conquat/DSP-hw/Modelli 3d/nc3mah.stp

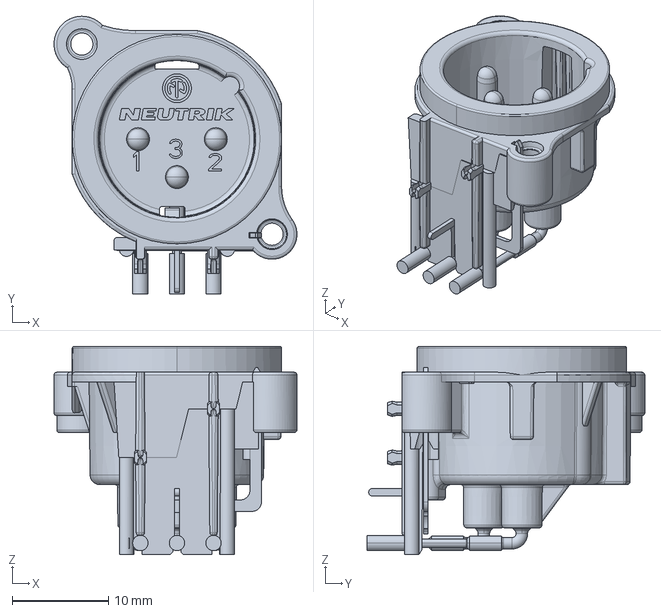
[picture p1: CAD file, 2026-07-23]
Modelli 3d/nc3mah.stp
25.3 x 28.9 x 21.7 mm
