conquat/DSP-hw/Modelli 3d/3D Model NCJ6FA-H.stp

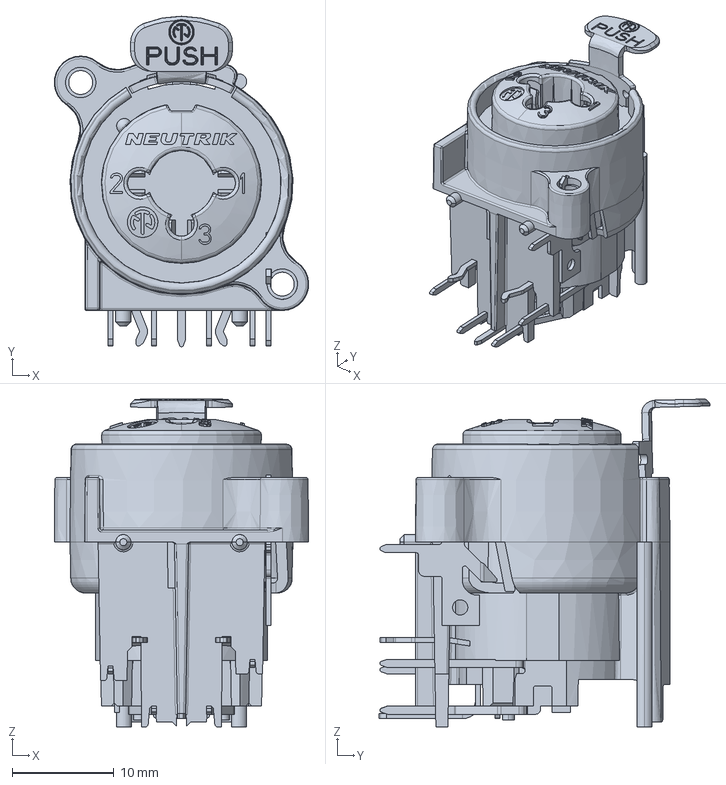
[picture p2: CAD file, 2026-07-23]
Modelli 3d/3D Model NCJ6FA-H.stp
25.0 x 32.5 x 32.2 mm
