conquat/DSP-hw/Modelli 3d/RK09Y11L0001.stp

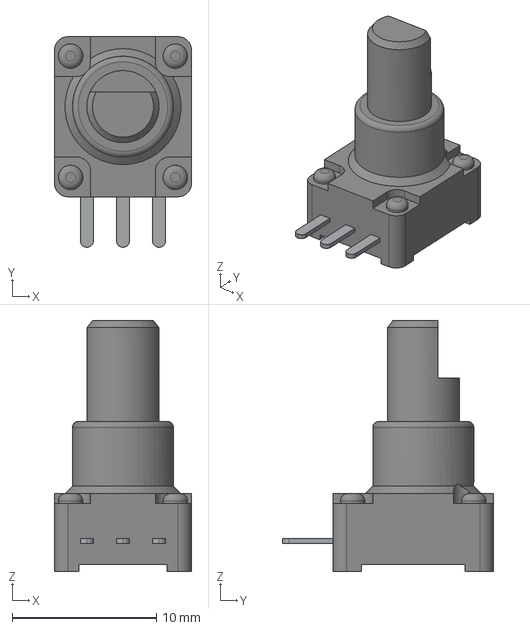
[picture p3: CAD file, 2026-07-23]
Modelli 3d/RK09Y11L0001.stp
9.50 x 14.6 x 17.4 mm
