conquat/DSP-hw/DSP-hw.kicad_pcb

## KiCad design DSP-hw.kicad_pcb (2026-08-07)

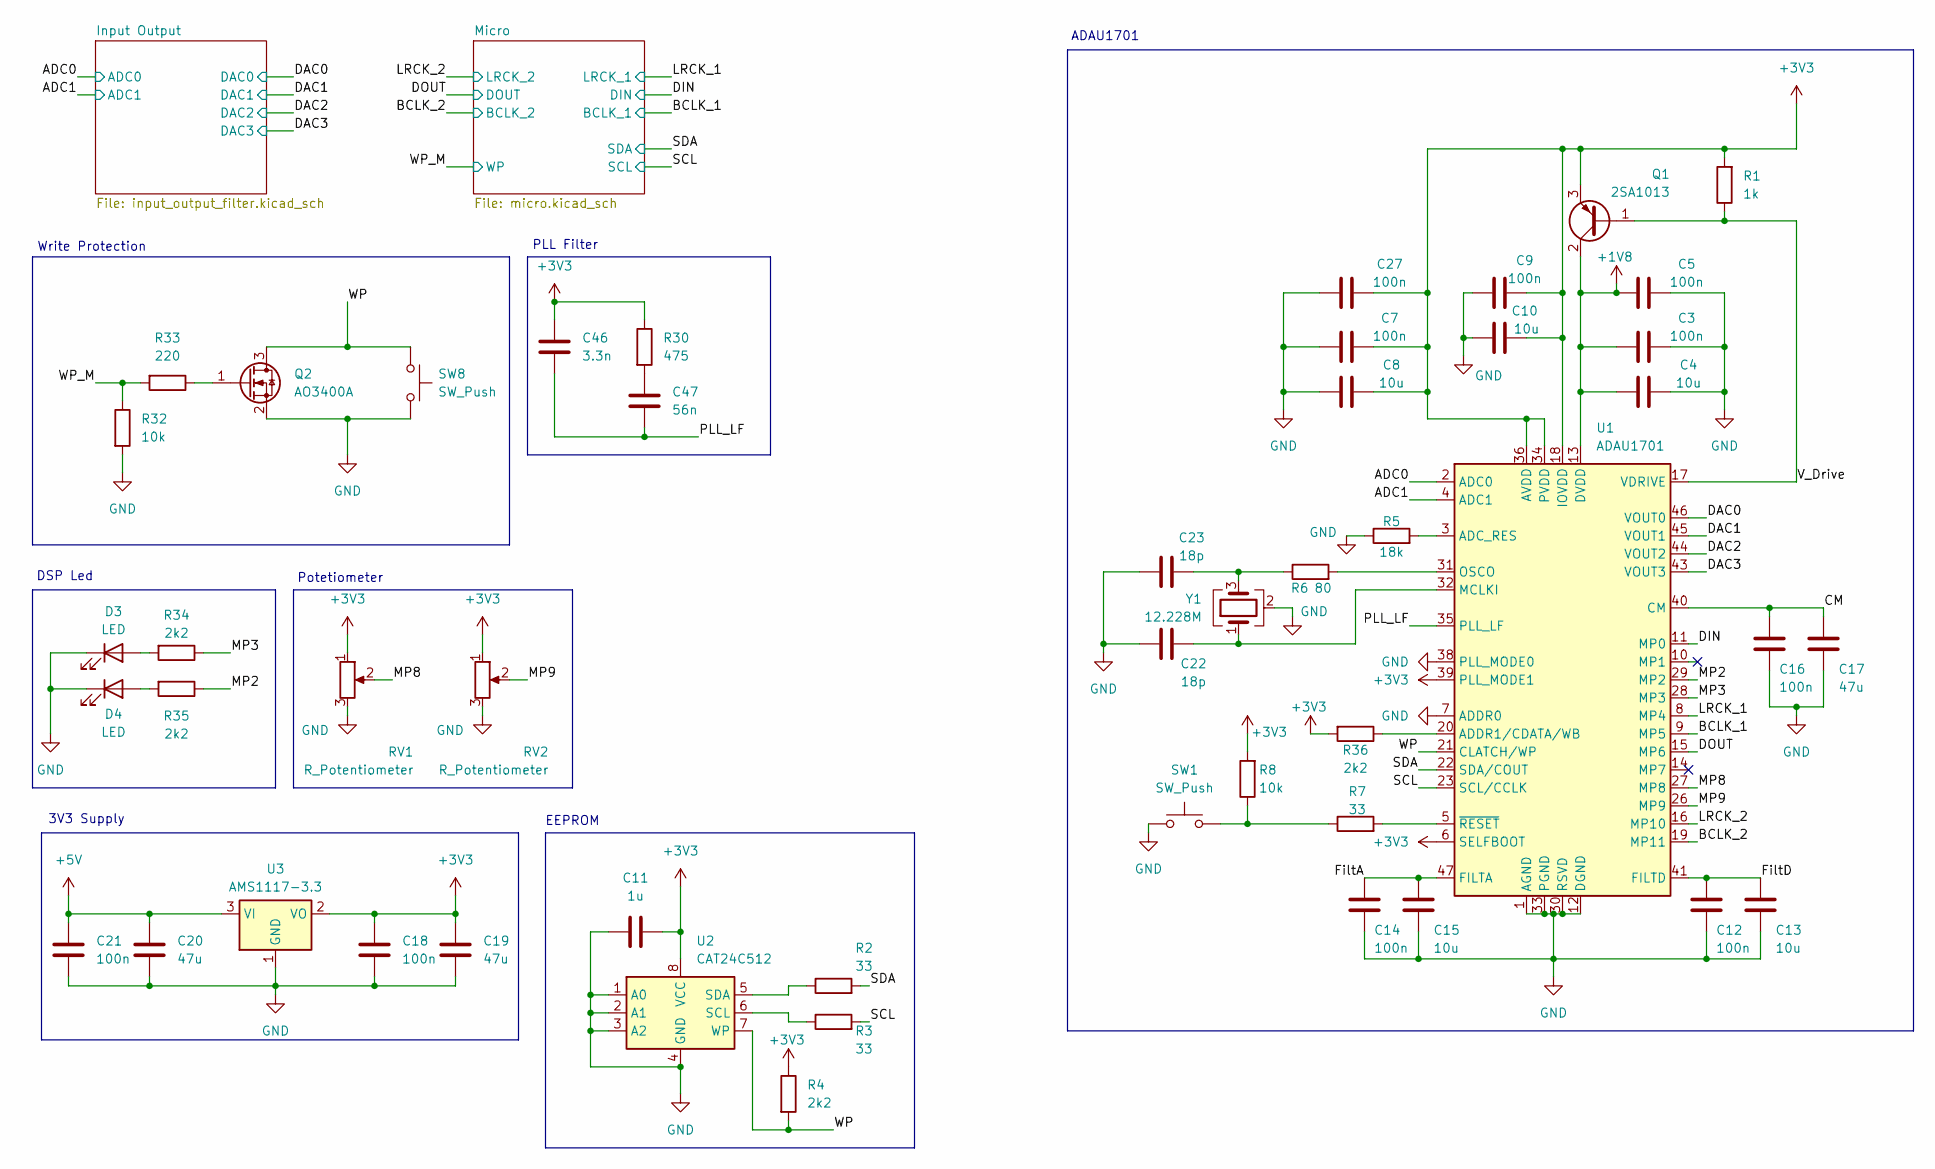
[picture p4: schematic DSP-hw.kicad_sch]

Parts:
C3, C5, C7, C9, C12, C14, C16, C18, C21, C27: 100n; C_0603_1608Metric
C4, C8, C10, C13, C15: 10u; C_0805_2012Metric
C11: 1u; C_0805_2012Metric
C17, C19, C20: 47u; C_Radial_D5.0mm_H11.0mm_P2.00mm
C22, C23: 18p; C_0603_1608Metric
C46: 3.3n; C_0603_1608Metric
C47: 56n; C_0603_1608Metric
D3, D4: LED; LED_1210_3225Metric
Q1: 2SA1013; SOT-89-3
Q2: AO3400A; SOT-23
R1: 1k; R_0603_1608Metric
R2, R3, R7: 33; R_0603_1608Metric
R4, R34, R35, R36: 2k2; R_0603_1608Metric
R5: 18k; R_0603_1608Metric
R6: 80; R_0603_1608Metric
R8, R32: 10k; R_0603_1608Metric
R30: 475; R_0603_1608Metric
R33: 220; R_0603_1608Metric
RV1, RV2: R_Potentiometer; Potentiometer_Alps_RK09Y11_Single_Horizontal
SW1, SW8: SW_Push; SW_SPST_PTS645Sx43SMTR92
U1: ADAU1701; LQFP-48_7x7mm_P0.5mm
U2: CAT24C512; SOIC-8_3.9x4.9mm_P1.27mm
U3: AMS1117-3.3; SOT-223-3_TabPin2
Y1: 12.228M; Crystal_SMD_3225-4Pin_3.2x2.5mm

Connections:
+1V8: C3.1, C4.1, C5.1, Q1.2 (C), U1.13 (DVDD), U1.24 (DVDD)
+3V3: C7.2, C8.2, C9.2, C10.2, C11.2, C18.1, C19.1, C27.2, C46.1, Q1.3 (E), R1.2, R4.1, R8.2, R30.1, R36.2, RV1.1, RV2.1, U1.6 (SELFBOOT), U1.18 (IOVDD), U1.34 (PVDD), U1.36 (AVDD), U1.39 (PLL_MODE1), U1.48 (AVDD), U2.8 (VCC), U3.2 (VO); also elsewhere on the board
+5V: C20.1, C21.1, U3.3 (VI); also elsewhere on the board
/ADC0: U1.2 (ADC0); also elsewhere on the board
/ADC1: U1.4 (ADC1); also elsewhere on the board
/BCLK_1: U1.9 (MP5); also elsewhere on the board
/BCLK_2: U1.19 (MP11); also elsewhere on the board
/CM: C16.1, C17.1, U1.40 (CM)
/DAC0: U1.46 (VOUT0); also elsewhere on the board
/DAC1: U1.45 (VOUT1); also elsewhere on the board
/DAC2: U1.44 (VOUT2); also elsewhere on the board
/DAC3: U1.43 (VOUT3); also elsewhere on the board
/DIN: U1.11 (MP0); also elsewhere on the board
/DOUT: U1.15 (MP6); also elsewhere on the board
/FiltA: C14.1, C15.1, U1.47 (FILTA)
/FiltD: C12.1, C13.1, U1.41 (FILTD)
/LRCK_1: U1.8 (MP4); also elsewhere on the board
/LRCK_2: U1.16 (MP10); also elsewhere on the board
/MP2: R35.1, U1.29 (MP2)
/MP3: R34.1, U1.28 (MP3)
/MP8: RV1.2, U1.27 (MP8)
/MP9: RV2.2, U1.26 (MP9)
/PLL_LF: C46.2, C47.2, U1.35 (PLL_LF)
/SCL: R3.2, U1.23 (SCL/CCLK); also elsewhere on the board
/SDA: R2.2, U1.22 (SDA/COUT); also elsewhere on the board
/V_Drive: Q1.1 (B), R1.1, U1.17 (VDRIVE)
/WP: Q2.3 (D), R4.2, SW8.1, U1.21 (CLATCH/WP), U2.7 (WP)
/WP_M: R32.1, R33.2; also elsewhere on the board
GND: C3.2, C4.2, C5.2, C7.1, C8.1, C9.1, C10.1, C11.1, C12.2, C13.2, C14.2, C15.2, C16.2, C17.2, C18.2, C19.2, C20.2, C21.2, C22.1, C23.1, C27.1, D3.1 (K), D4.1 (K), Q2.2 (S), R5.1, R32.2, RV1.3, RV2.3, SW1.1, SW8.2, U1.1 (AGND), U1.7 (ADDR0), U1.12 (DGND), U1.25 (DGND), U1.30 (RSVD), U1.33 (PGND), U1.37 (AGND), U1.38 (PLL_MODE0), U1.42 (AGND), U2.1 (A0), U2.2 (A1), U2.3 (A2), U2.4 (GND), U3.1 (GND), Y1.2 (G), Y1.4 (G); also elsewhere on the board
unnamed: C23.2, R6.1, Y1.3
unnamed: C47.1, R30.2
unnamed: D3.2 (A), R34.2
unnamed: D4.2 (A), R35.2
unnamed: Q2.1 (G), R33.1
unnamed: R7.1, R8.1, SW1.2
unnamed: R5.2, U1.3 (ADC_RES)
unnamed: R36.1, U1.20 (ADDR1/CDATA/WB)
unnamed: C22.2, U1.32 (MCLKI), Y1.1
unnamed: R6.2, U1.31 (OSCO)
unnamed: R7.2, U1.5 (~RESET)
unnamed: R3.1, U2.6 (SCL)
unnamed: R2.1, U2.5 (SDA)

Notes on the sheet:
3V3 Supply
ADAU1701
EEPROM
Write Protection
DSP Led
Potetiometer
PLL Filter

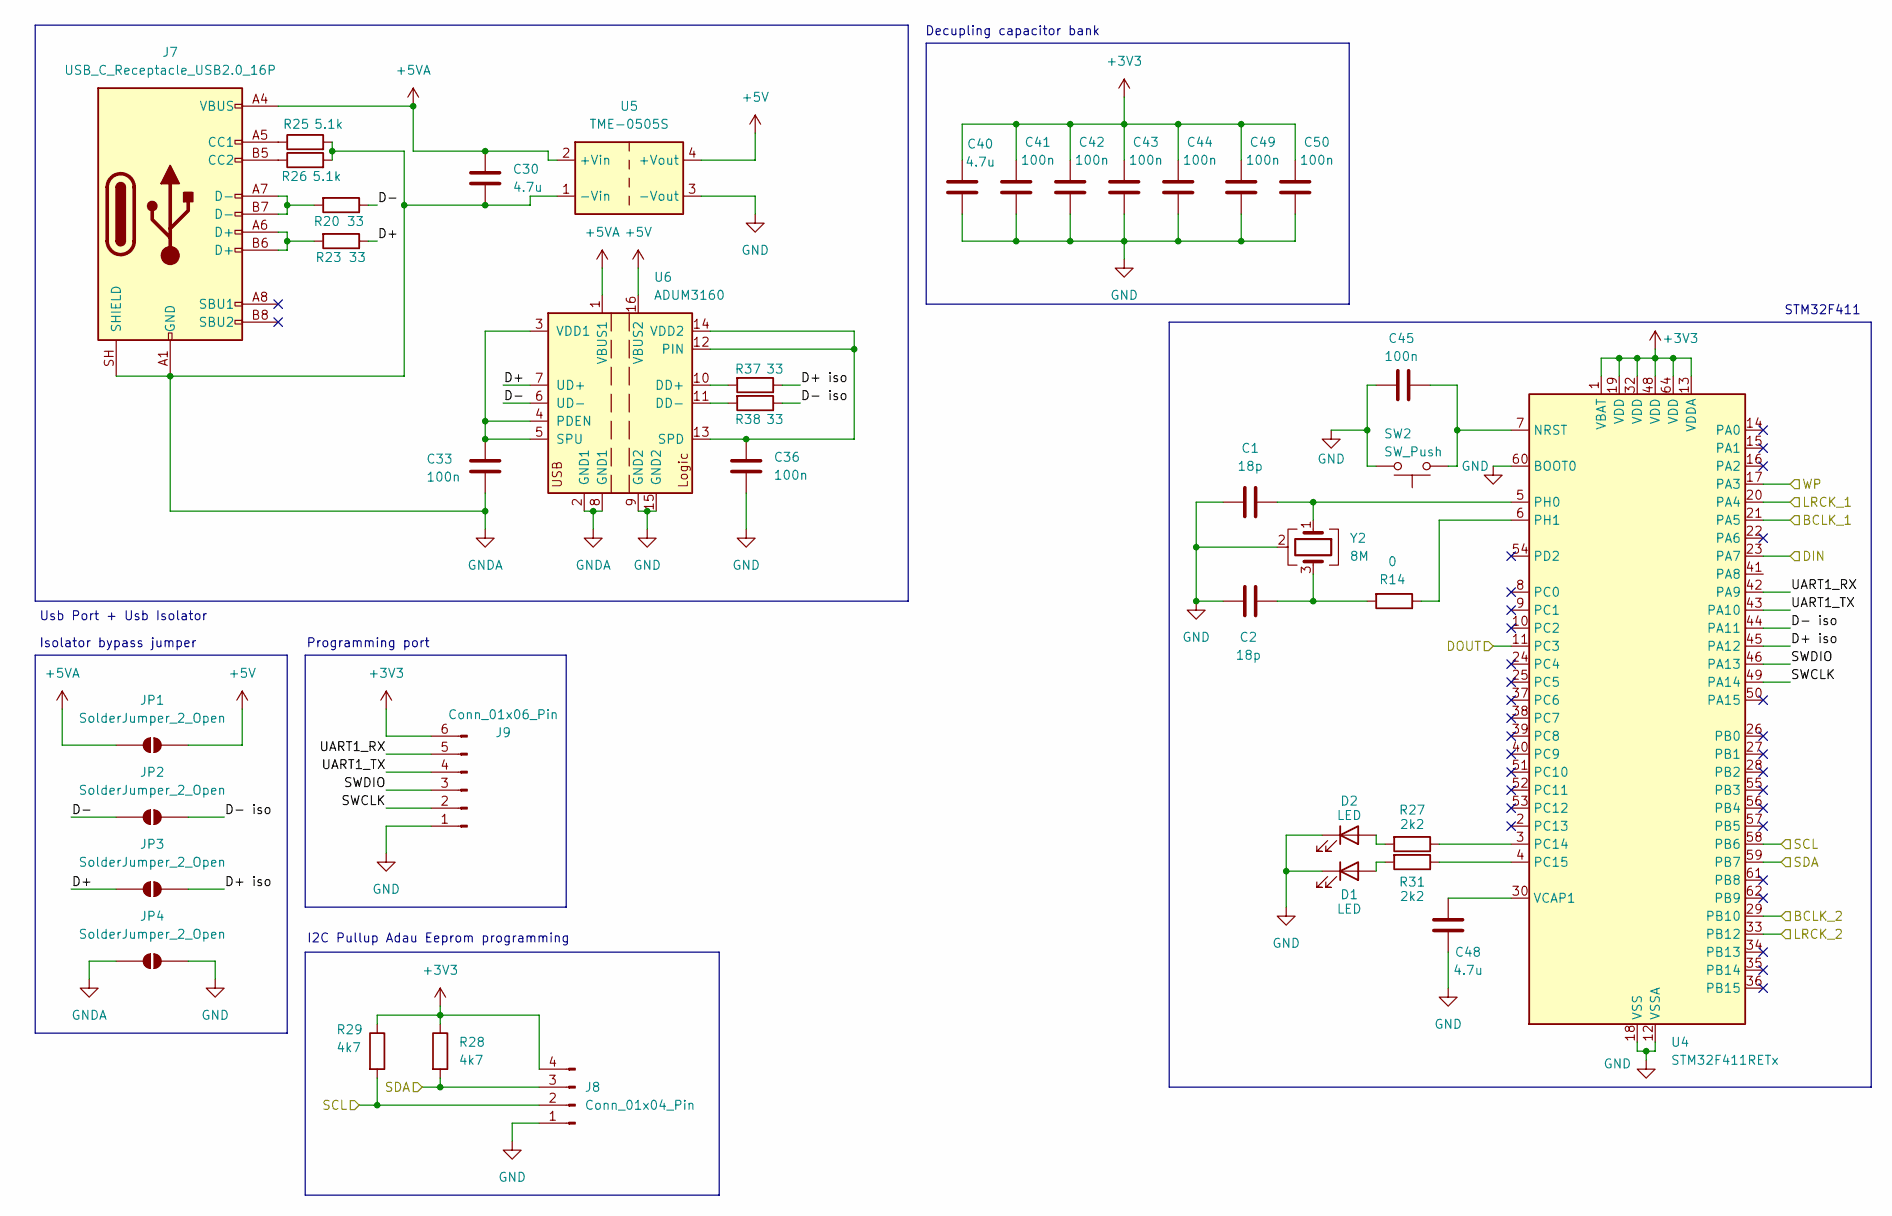
[picture p5: schematic micro.kicad_sch]

Parts:
C1, C2: 18p; C_0603_1608Metric
C30, C40, C48: 4.7u; C_Radial_D4.0mm_H7.0mm_P1.50mm
C33, C36, C41, C42, C43, C44, C45, C49, C50: 100n; C_0603_1608Metric
D1, D2: LED; LED_1210_3225Metric
J7: USB_C_Receptacle_USB2.0_16P; USB_C_Receptacle_GCT_USB4105-xx-A_16P_TopMnt_Horizontal
J8: Conn_01x04_Pin; JST_XH_B4B-XH-A_1x04_P2.50mm_Vertical
J9: Conn_01x06_Pin; JST_XH_B6B-XH-A_1x06_P2.50mm_Vertical
JP1, JP2, JP3, JP4: SolderJumper_2_Open; SolderJumper-2_P1.3mm_Open_TrianglePad1.0x1.5mm
R14: 0; R_0603_1608Metric
R20, R23, R37, R38: 33; R_0603_1608Metric
R25, R26: 5.1k; R_0603_1608Metric
R27, R31: 2k2; R_0603_1608Metric
R28, R29: 4k7; R_0603_1608Metric
SW2: SW_Push; SW_SPST_PTS645Sx43SMTR92
U4: STM32F411RETx; LQFP-64_10x10mm_P0.5mm
U5: TME-0505S; Converter_DCDC_TRACO_TME_03xxS_05xxS_12xxS_Single_THT
U6: ADUM3160; SOIC-16W_7.5x10.3mm_P1.27mm
Y2: 8M; Crystal_SMD_3225-4Pin_3.2x2.5mm

Connections:
+3V3: C40.1, C41.1, C42.1, C43.1, C44.1, C49.1, C50.1, J8.4, J9.6, R28.1, R29.1, U4.1 (VBAT), U4.13 (VDDA), U4.19 (VDD), U4.32 (VDD), U4.48 (VDD), U4.64 (VDD); also elsewhere on the board
+5V: JP1.2 (B), U5.4 (+Vout), U6.16 (VBUS2); also elsewhere on the board
+5VA: C30.1, J7.A4 (VBUS), J7.A9 (VBUS), J7.B4 (VBUS), J7.B9 (VBUS), JP1.1 (A), U5.2 (+Vin), U6.1 (VBUS1)
/BCLK_1: U4.21 (PA5); also elsewhere on the board
/BCLK_2: U4.29 (PB10); also elsewhere on the board
/DIN: U4.23 (PA7); also elsewhere on the board
/DOUT: U4.11 (PC3); also elsewhere on the board
/LRCK_1: U4.20 (PA4); also elsewhere on the board
/LRCK_2: U4.33 (PB12); also elsewhere on the board
/Micro/D+: JP3.1 (A), R23.1, U6.7 (UD+)
/Micro/D+ iso: JP3.2 (B), R37.1, U4.45 (PA12)
/Micro/D-: JP2.1 (A), R20.1, U6.6 (UD-)
/Micro/D- iso: JP2.2 (B), R38.1, U4.44 (PA11)
/Micro/SWCLK: J9.2, U4.49 (PA14)
/Micro/SWDIO: J9.3, U4.46 (PA13)
/Micro/UART1_RX: J9.5, U4.42 (PA9)
/Micro/UART1_TX: J9.4, U4.43 (PA10)
/SCL: J8.2, R29.2, U4.58 (PB6); also elsewhere on the board
/SDA: J8.3, R28.2, U4.59 (PB7); also elsewhere on the board
/WP_M: U4.17 (PA3); also elsewhere on the board
GND: C1.1, C2.1, C36.2, C40.2, C41.2, C42.2, C43.2, C44.2, C45.2, C48.2, C49.2, C50.2, D1.1 (K), D2.1 (K), J8.1, J9.1, JP4.2 (B), SW2.2, U4.12 (VSSA), U4.18 (VSS), U4.31 (VSS), U4.47 (VSS), U4.60 (BOOT0), U4.63 (VSS), U5.3 (-Vout), U6.9 (GND2), U6.15 (GND2), Y2.2 (G), Y2.4 (G); also elsewhere on the board
GNDA: C30.2, C33.2, J7.A1 (GND), J7.A12 (GND), J7.B1 (GND), J7.B12 (GND), J7.SH (SHIELD), JP4.1 (A), R25.2, R26.2, U5.1 (-Vin), U6.2 (GND1), U6.8 (GND1)
unnamed: C2.2, R14.2, Y2.3
unnamed: D1.2 (A), R31.2
unnamed: D2.2 (A), R27.2
unnamed: J7.A5 (CC1), R25.1
unnamed: J7.B5 (CC2), R26.1
unnamed: J7.A6 (D+), J7.B6 (D+), R23.2
unnamed: J7.A7 (D-), J7.B7 (D-), R20.2
unnamed: C45.1, SW2.1, U4.7 (NRST)
unnamed: R27.1, U4.3 (PC14)
unnamed: R31.1, U4.4 (PC15)
unnamed: C1.2, U4.5 (PH0), Y2.1
unnamed: R14.1, U4.6 (PH1)
unnamed: C48.1, U4.30 (VCAP1)
unnamed: R37.2, U6.10 (DD+)
unnamed: R38.2, U6.11 (DD-)
unnamed: C33.1, U6.3 (VDD1), U6.4 (PDEN), U6.5 (SPU)
unnamed: C36.1, U6.12 (PIN), U6.13 (SPD), U6.14 (VDD2)

Notes on the sheet:
STM32F411
Usb Port + Usb Isolator
Programming port
I2C Pullup Adau Eeprom programming
Isolator bypass jumper
Decupling capacitor bank

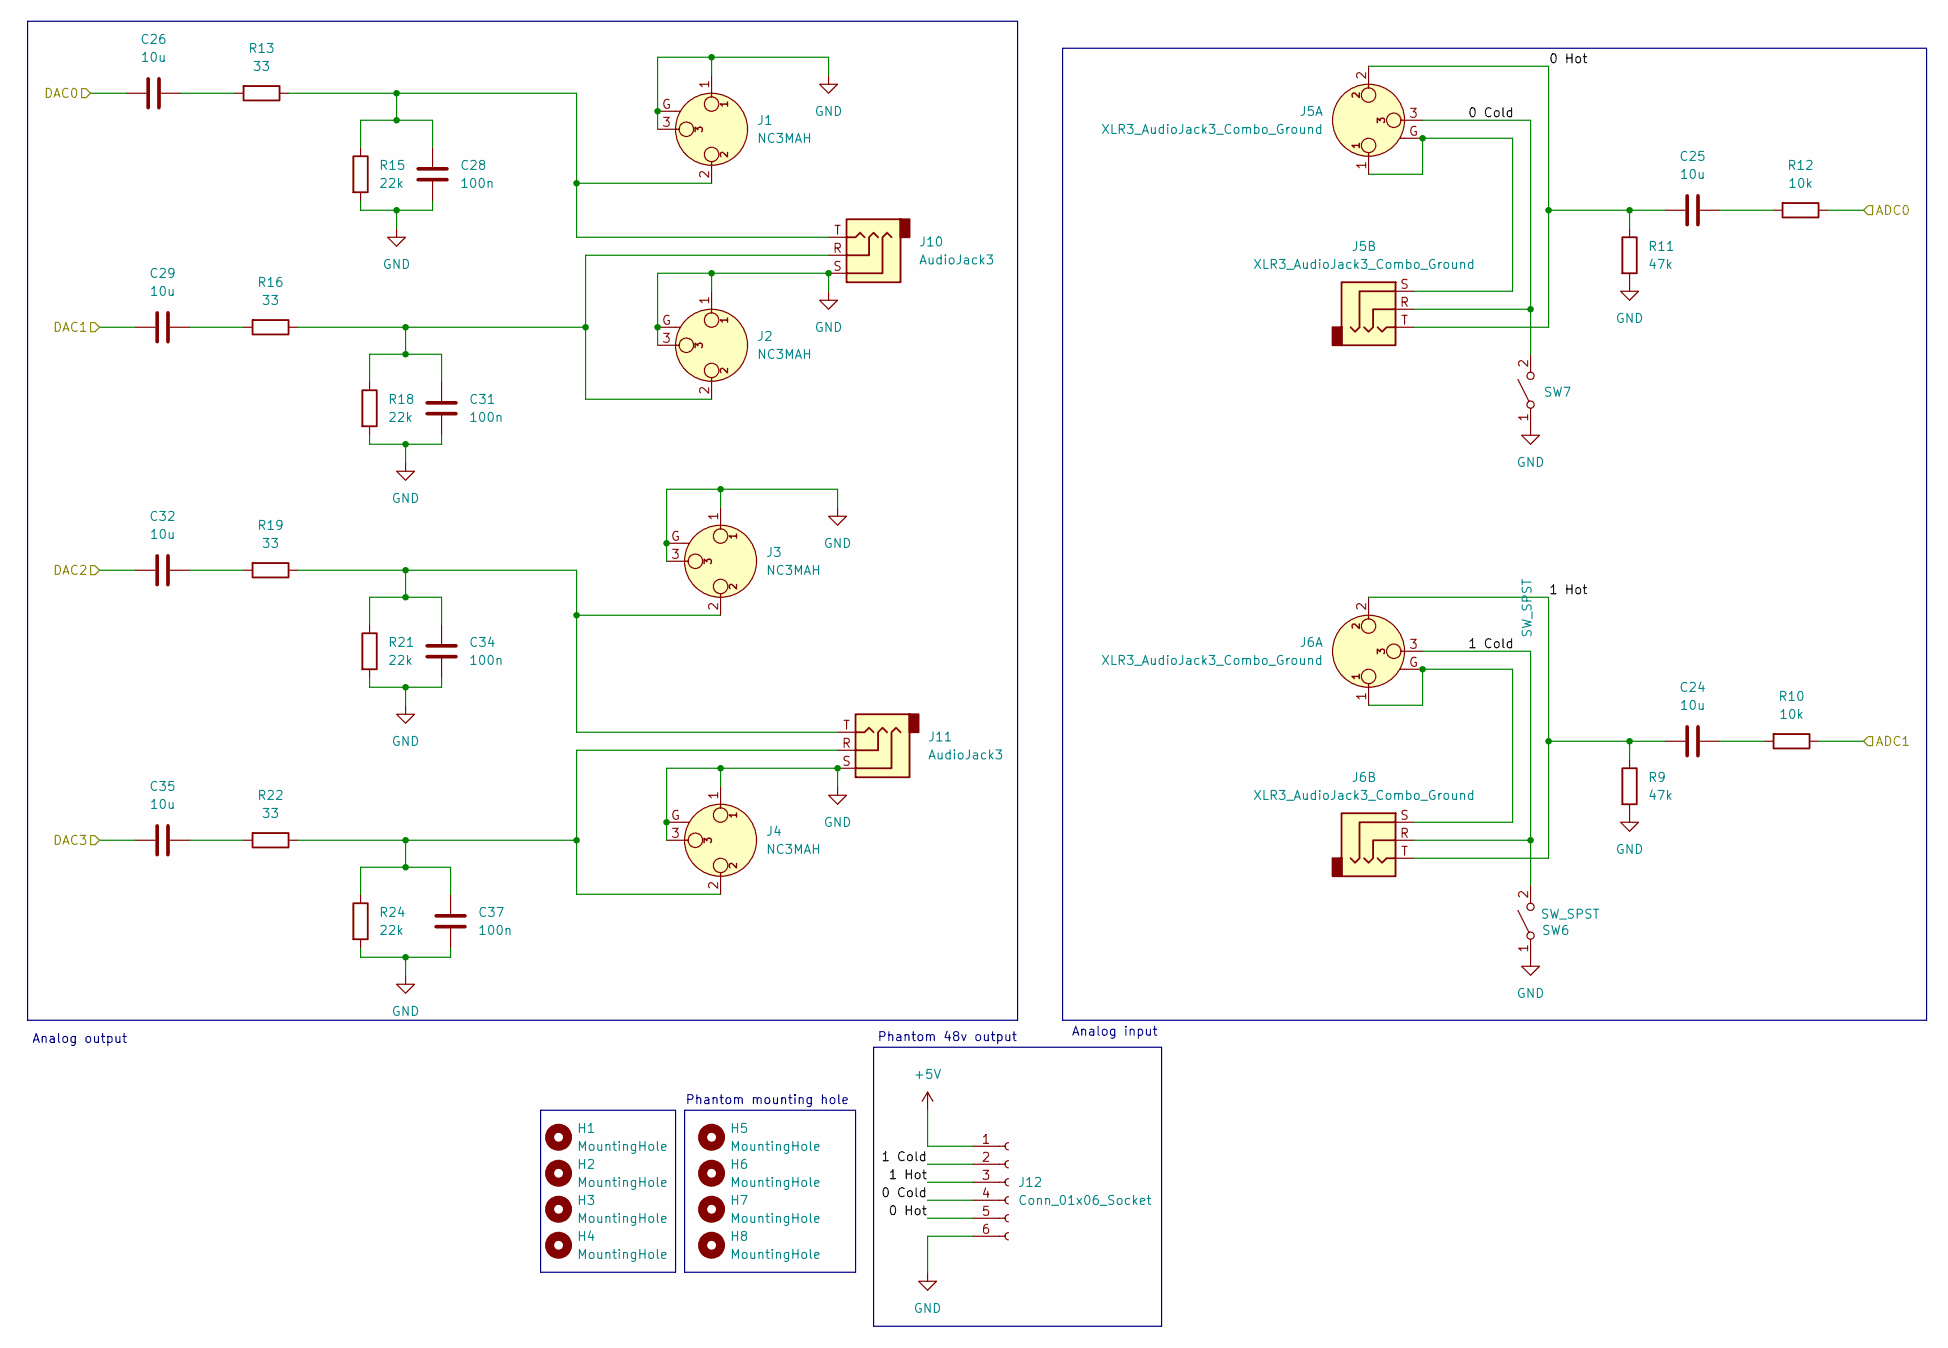
[picture p6: schematic input_output_filter.kicad_sch]

Parts:
C24, C25, C26, C29, C32, C35: 10u; C_0805_2012Metric
C28, C31, C34, C37: 100n; C_0603_1608Metric
H1, H2, H3, H4: MountingHole; MountingHole_3.2mm_M3_Pad_Via
H5, H6, H7, H8: MountingHole; MountingHole_2.2mm_M2_Pad_Via
J1, J2, J3, J4: NC3MAH; Jack_XLR_Neutrik_NC3MAH_Horizontal
J5, J6: XLR3_AudioJack3_Combo_Ground; Jack_XLR-6.35mm_Neutrik_NCJ6FA-H-0_Horizontal
J10, J11: AudioJack3; Jack_3.5mm_CUI_SJ1-3523N_Horizontal
J12: Conn_01x06_Socket; PinHeader_1x06_P2.54mm_Vertical
R9, R11: 47k; R_0603_1608Metric
R10, R12: 10k; R_0603_1608Metric
R13, R16, R19, R22: 33; R_0603_1608Metric
R15, R18, R21, R24: 22k; R_0603_1608Metric
SW6, SW7: SW_SPST; SW_DIP_SPSTx01_Slide_9.78x4.72mm_W7.62mm_P2.54mm

Connections:
+5V: J12.1; also elsewhere on the board
/ADC0: R12.1; also elsewhere on the board
/ADC1: R10.1; also elsewhere on the board
/DAC0: C26.1; also elsewhere on the board
/DAC1: C29.1; also elsewhere on the board
/DAC2: C32.1; also elsewhere on the board
/DAC3: C35.1; also elsewhere on the board
/Input Output/0 Cold: J5.3, J5.R, J12.4, SW7.2 (B)
/Input Output/0 Hot: C25.1, J5.2, J5.T, J12.5, R11.1
/Input Output/1 Cold: J6.3, J6.R, J12.2, SW6.2 (B)
/Input Output/1 Hot: C24.1, J6.2, J6.T, J12.3, R9.1
GND: C28.2, C31.2, C34.2, C37.2, J1.1, J1.3, J1.G, J2.1, J2.3, J2.G, J3.1, J3.3, J3.G, J4.1, J4.3, J4.G, J10.S, J11.S, J12.6, R9.2, R11.2, R15.2, R18.2, R21.2, R24.2, SW6.1 (A), SW7.1 (A); also elsewhere on the board
unnamed: C24.2, R10.2
unnamed: C25.2, R12.2
unnamed: C26.2, R13.2
unnamed: C28.1, J1.2, J10.T, R13.1, R15.1
unnamed: C29.2, R16.2
unnamed: C31.1, J2.2, J10.R, R16.1, R18.1
unnamed: C32.2, R19.2
unnamed: C34.1, J3.2, J11.T, R19.1, R21.1
unnamed: C35.2, R22.2
unnamed: C37.1, J4.2, J11.R, R22.1, R24.1
unnamed: J5.1, J5.G, J5.S
unnamed: J6.1, J6.G, J6.S

Notes on the sheet:
Phantom 48v output
Phantom mounting hole
Analog output
Analog input

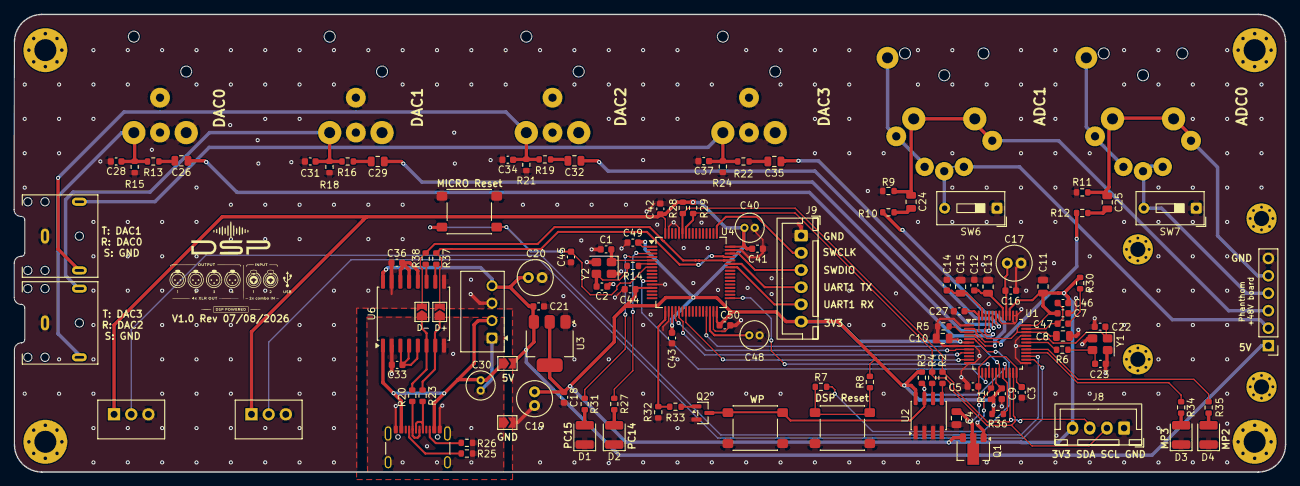
[picture p7: board DSP-hw.kicad_pcb from above]

Board: 2 copper layers, 185.0 x 66.6 mm, 129 parts (0 on the bottom side), 85 nets.
