conquat/DSP-hw/(commit log)

2026-07-20 Iniziata un po la schematica
    [DSP-hw.kicad_pcb, DSP-hw.kicad_sch, input_output_filter.kicad_sch, micro.kicad_sch]
2026-07-20 aggiunto filtro PLL_LF Adau
    [DSP-hw.kicad_pcb, DSP-hw.kicad_sch, input_output_filter.kicad_sch, micro.kicad_sch]
2026-07-20 sostituito micro esp32 a stm32
    [DSP-hw.kicad_pcb, DSP-hw.kicad_sch, input_output_filter.kicad_sch, micro.kicad_sch]
2026-07-23 aggiunto cad 3d dei connettori
    [3D Model NCJ6FA-H.stp, DSP-hw.kicad_pcb, DSP-hw.kicad_sch, RK09Y11L0001.stp, input_output_filter.kicad_sch, micro.kicad_sch, nc3mah.stp]
2026-07-23 cambiato di nuovo il micro ad un f411 costava troppo il g4
    [DSP-hw-B_Cu.gbr, DSP-hw-B_Mask.gbr, DSP-hw-B_Paste.gbr, DSP-hw-B_Silkscreen.gbr, DSP-hw-Edge_Cuts.gbr, DSP-hw-F_Cu.gbr, DSP-hw-F_Mask.gbr, DSP-hw-F_Paste.gbr]
2026-07-23 errore alla coca
    [DSP-hw.kicad_pcb, input_output_filter.kicad_sch, micro.kicad_sch]
2026-07-24 recuperata versione di ieri
    [DSP-hw.kicad_pcb, DSP-hw.kicad_sch, input_output_filter.kicad_sch, micro.kicad_sch]
2026-07-27 routing iniziale
    [DSP-hw.kicad_pcb, input_output_filter.kicad_sch, micro.kicad_sch]
2026-07-27 routing praticamente fatto forse
    [DSP-hw-B_Cu.gbr, DSP-hw-B_Mask.gbr, DSP-hw-B_Paste.gbr, DSP-hw-B_Silkscreen.gbr, DSP-hw-Edge_Cuts.gbr, DSP-hw-F_Cu.gbr, DSP-hw-F_Mask.gbr, DSP-hw-F_Paste.gbr]
2026-07-28 cambiato connettori jack
    [DSP-hw.kicad_pcb, input_output_filter.kicad_sch, jlc_v2_bom.csv, jlc_v2_designators.csv, jlc_v2_positions.csv]
2026-07-28 passato tutto a due layer
    [DSP-hw-B_Cu.gbr, DSP-hw-B_Mask.gbr, DSP-hw-B_Paste.gbr, DSP-hw-B_Silkscreen.gbr, DSP-hw-Edge_Cuts.gbr, DSP-hw-F_Cu.gbr, DSP-hw-F_Mask.gbr, DSP-hw-F_Paste.gbr]
2026-07-29 aggiunto oscillatore allo schematico
    [DSP-hw.kicad_pcb, DSP-hw.kicad_sch, micro.kicad_sch]
2026-07-30 sostituito dei componenti non piu disponibili
    [DSP-hw.kicad_pcb, DSP-hw.kicad_sch, micro.kicad_sch]
2026-08-03 modifiche suggerite da osti
    [DSP-hw.kicad_pcb, DSP-hw.kicad_sch, input_output_filter.kicad_sch, jlc_v3_bom.csv, jlc_v3_designators.csv, jlc_v3_positions.csv, micro.kicad_sch]
2026-08-03 messa apposto la silkscreen
    [DSP-hw.kicad_pcb, DSP-hw.kicad_sch, jlc_v4_bom.csv, jlc_v4_designators.csv, jlc_v4_positions.csv]
2026-08-04 bom completata
    [DSP-hw.csv, DSP-hw.kicad_pcb, DSP-hw.kicad_sch, input_output_filter.kicad_sch, micro.kicad_sch]
2026-08-07 pulito lo schematico e fatto dei check
    [DSP-hw-B_Cu.gbr, DSP-hw-B_Mask.gbr, DSP-hw-B_Paste.gbr, DSP-hw-B_Silkscreen.gbr, DSP-hw-Edge_Cuts.gbr, DSP-hw-F_Cu.gbr, DSP-hw-F_Mask.gbr, DSP-hw-F_Paste.gbr]
